anudeeps28/WhackAMole_Bot/README.md

# Whack-A-Mole Robot
ME 588: Mechatronics Final project
